4x4eb/micro-vhf-uhf-repeater/img/VU_Radio-Arduino_3D.jpg

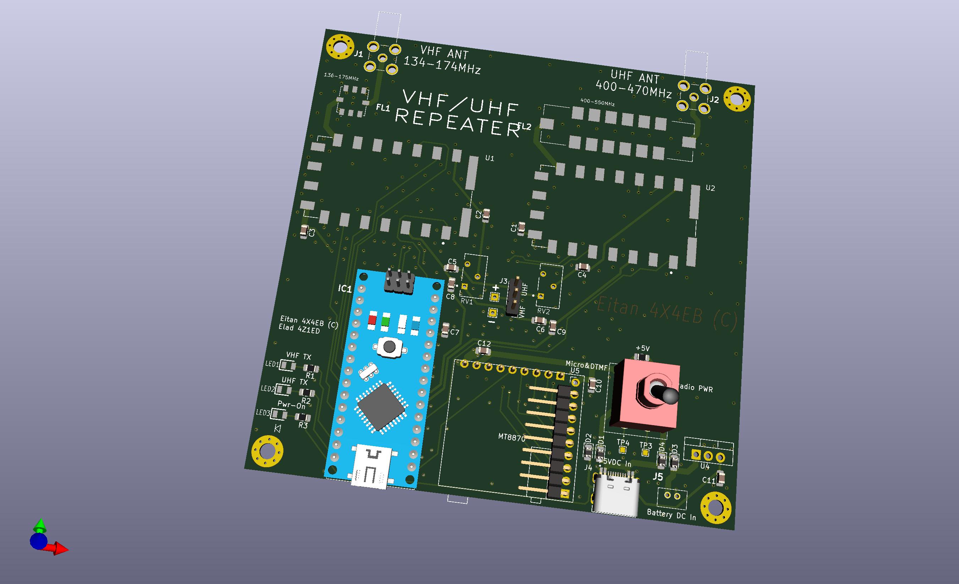
img/VU_Radio-Arduino_3D.jpg
