4x4eb/micro-vhf-uhf-repeater/img/vhf_uhf_repeater scheme.png

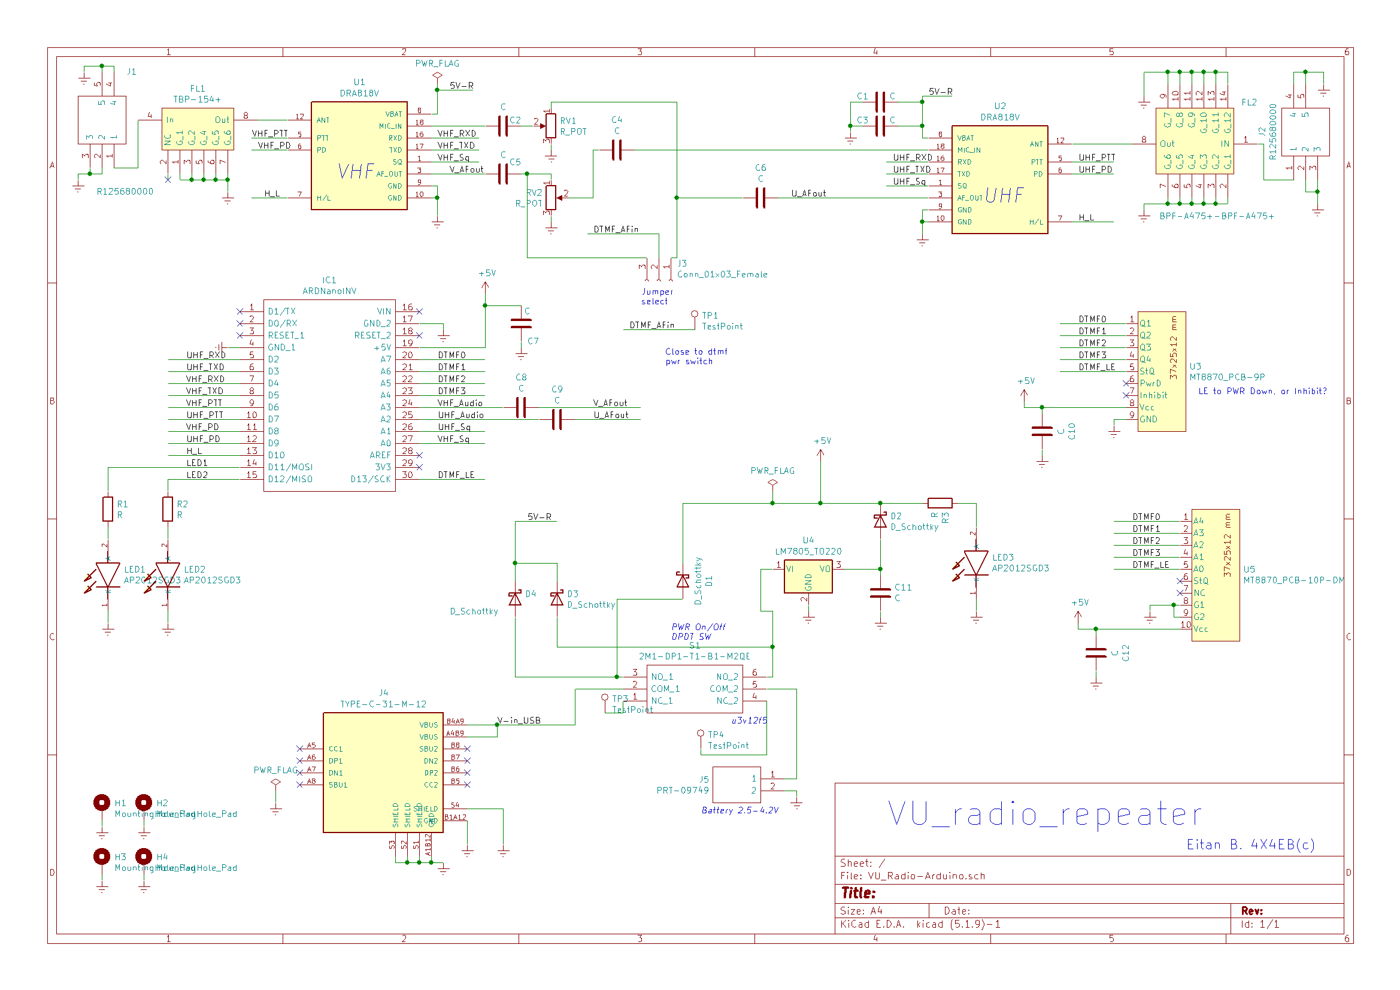
img/vhf_uhf_repeater scheme.png
