4x4eb/micro-vhf-uhf-repeater/VU-Repeater_BOm.xlsx

Reference | Quantity | Value | Footprint | MNF PN | MOUSER
C6 C4 C2 C5 C11 C1 C3 C10 C7 C8 C9 C12 | 12 | C= 10uf smd1206 | Capacitor_SMD:C_0805_2012Metric_Pad1.15x1.40mm_HandSolder
D2 D1 D3 D4 | 4 | D_Schottky | can use 0ohm res if u do not use 2 sorces | SD0805S020S1R0 | https://www.mouser.co.il/ProductDetail/AVX/SD0805S020S1R0/?qs=jCA%252BPfw4LHbpkAoSnwrdjw%3D%3D
FL1 | 1 | TBP-154+ | vhf filter
FL2 | 1 | BPF-A475+-BPF-A475+ | uhf filter
IC1 | 1 | ARDNanoINV | arduino nano
J1 J2 | 2 | R125680000 | R125680000:R125680000
J3 | 1 | Conn_01x03_Female | Connector_PinHeader_2.54mm:PinHeader_1x03_P2.54mm_Vertical
J4 | 1 | TYPE-C-31-M-12 | TYPE-C-31-M-12_lib:HRO_TYPE-C-31-M-12
J5 | 1 | PRT-09749
LED2 LED1 LED3 | 3 | 12o6 led
R2 R1 R3 100-200 ohm | 4 | R 1206
RV2 RV1 | 2 | R_POT | Potentiometer10K_1041501525:TRIM_67ZR5KLF
S1 | 1 | 2M1-DP1-T1-B1-M2QE | 2M1-DP1-T1-B1-M2QE:2M1DP1T1B1M2QE | 2M1-DP1-T1-B1-M2QE | https://www.mouser.co.il/ProductDetail/Carling-Technologies/2M1-DP1-T1-B1-M2QE/
U1 | 1 | DRA818V
U2 | 1 | DRA818U | DRA818V_Lib:DORJI_DRA818V
U3 | 1 | MT8870_PCB-9P | DRA818V_Lib:DTMF_MT8870 | optional
U4 | 1 | 1. dc-dc module - S7V7F5 |  | optional
U5 | 1 | MT8870_PCB-10P-DM | DRA818V_Lib:DTMF_MT8870_10p | optional
